PhoenixbornTech/DigiBadge/SDCARD/green.bmp

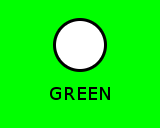
SDCARD/green.bmp
