PhoenixbornTech/DigiBadge/SDCARD/red.bmp

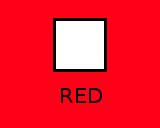
SDCARD/red.bmp
