PhoenixbornTech/DigiBadge/SDCARD/yellow.bmp

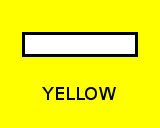
SDCARD/yellow.bmp
