PhoenixbornTech/DigiBadge/digibadge_B_AAAx2_R_rev13b.pdf

# ATMEGA168A-PU

# ATMEGA 168/328

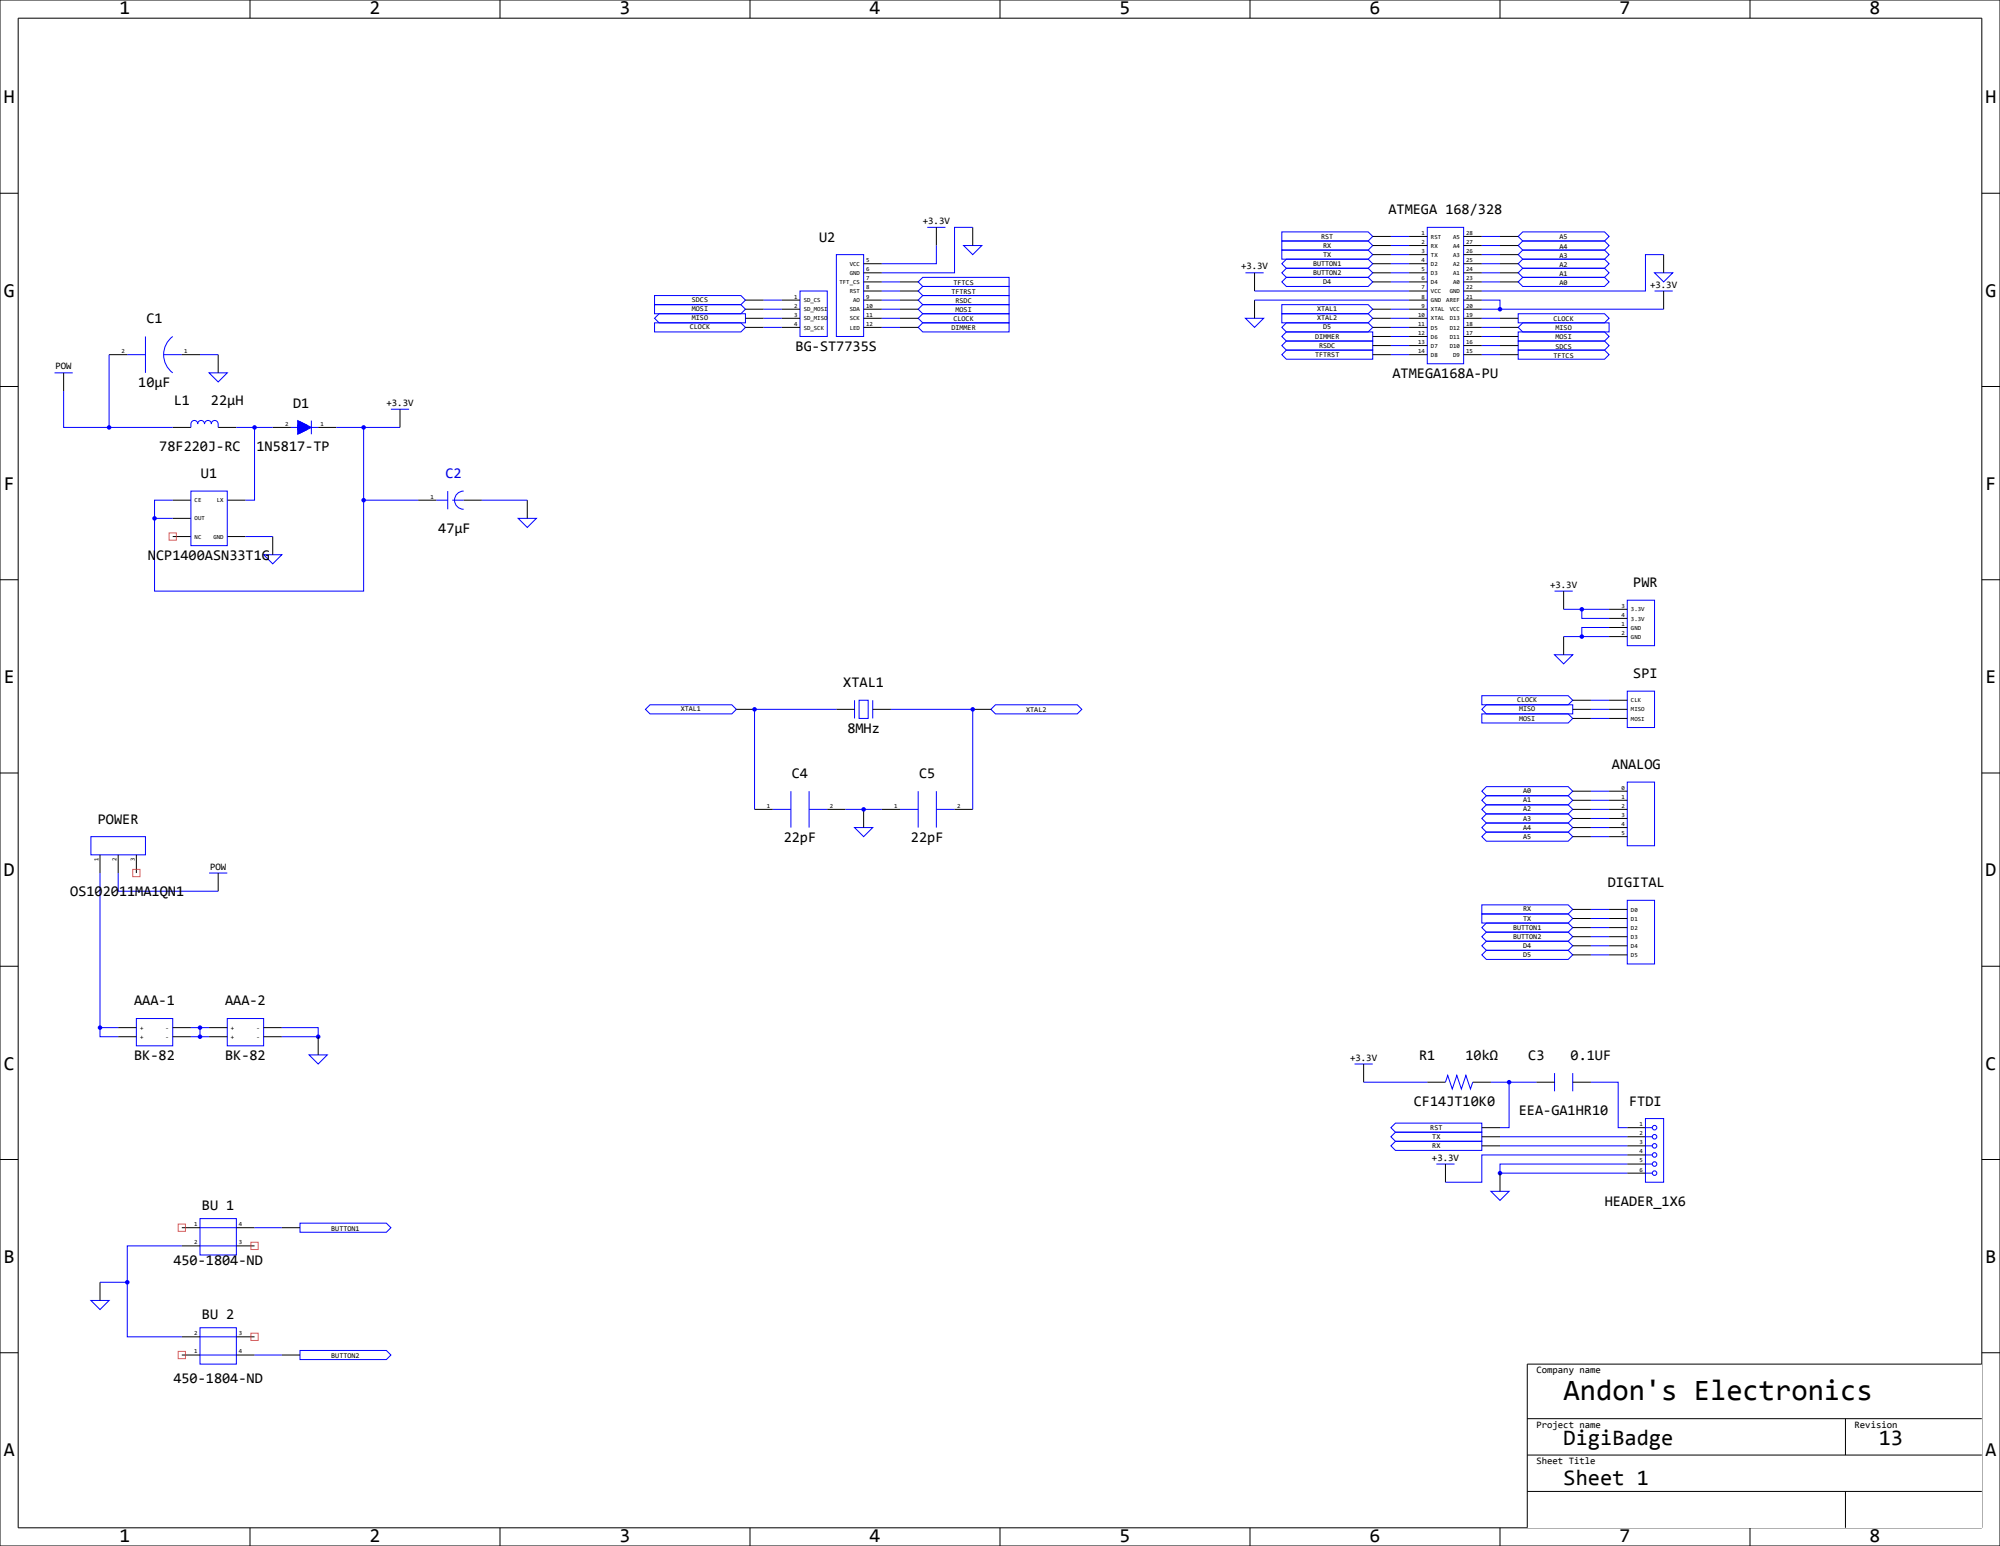
[picture p4: page 1]
