PhoenixbornTech/DigiBadge/digibadge_B_AAAx2_R_rev13.pdf

# ATMEGA168A-PU

# ATMEGA 168/328

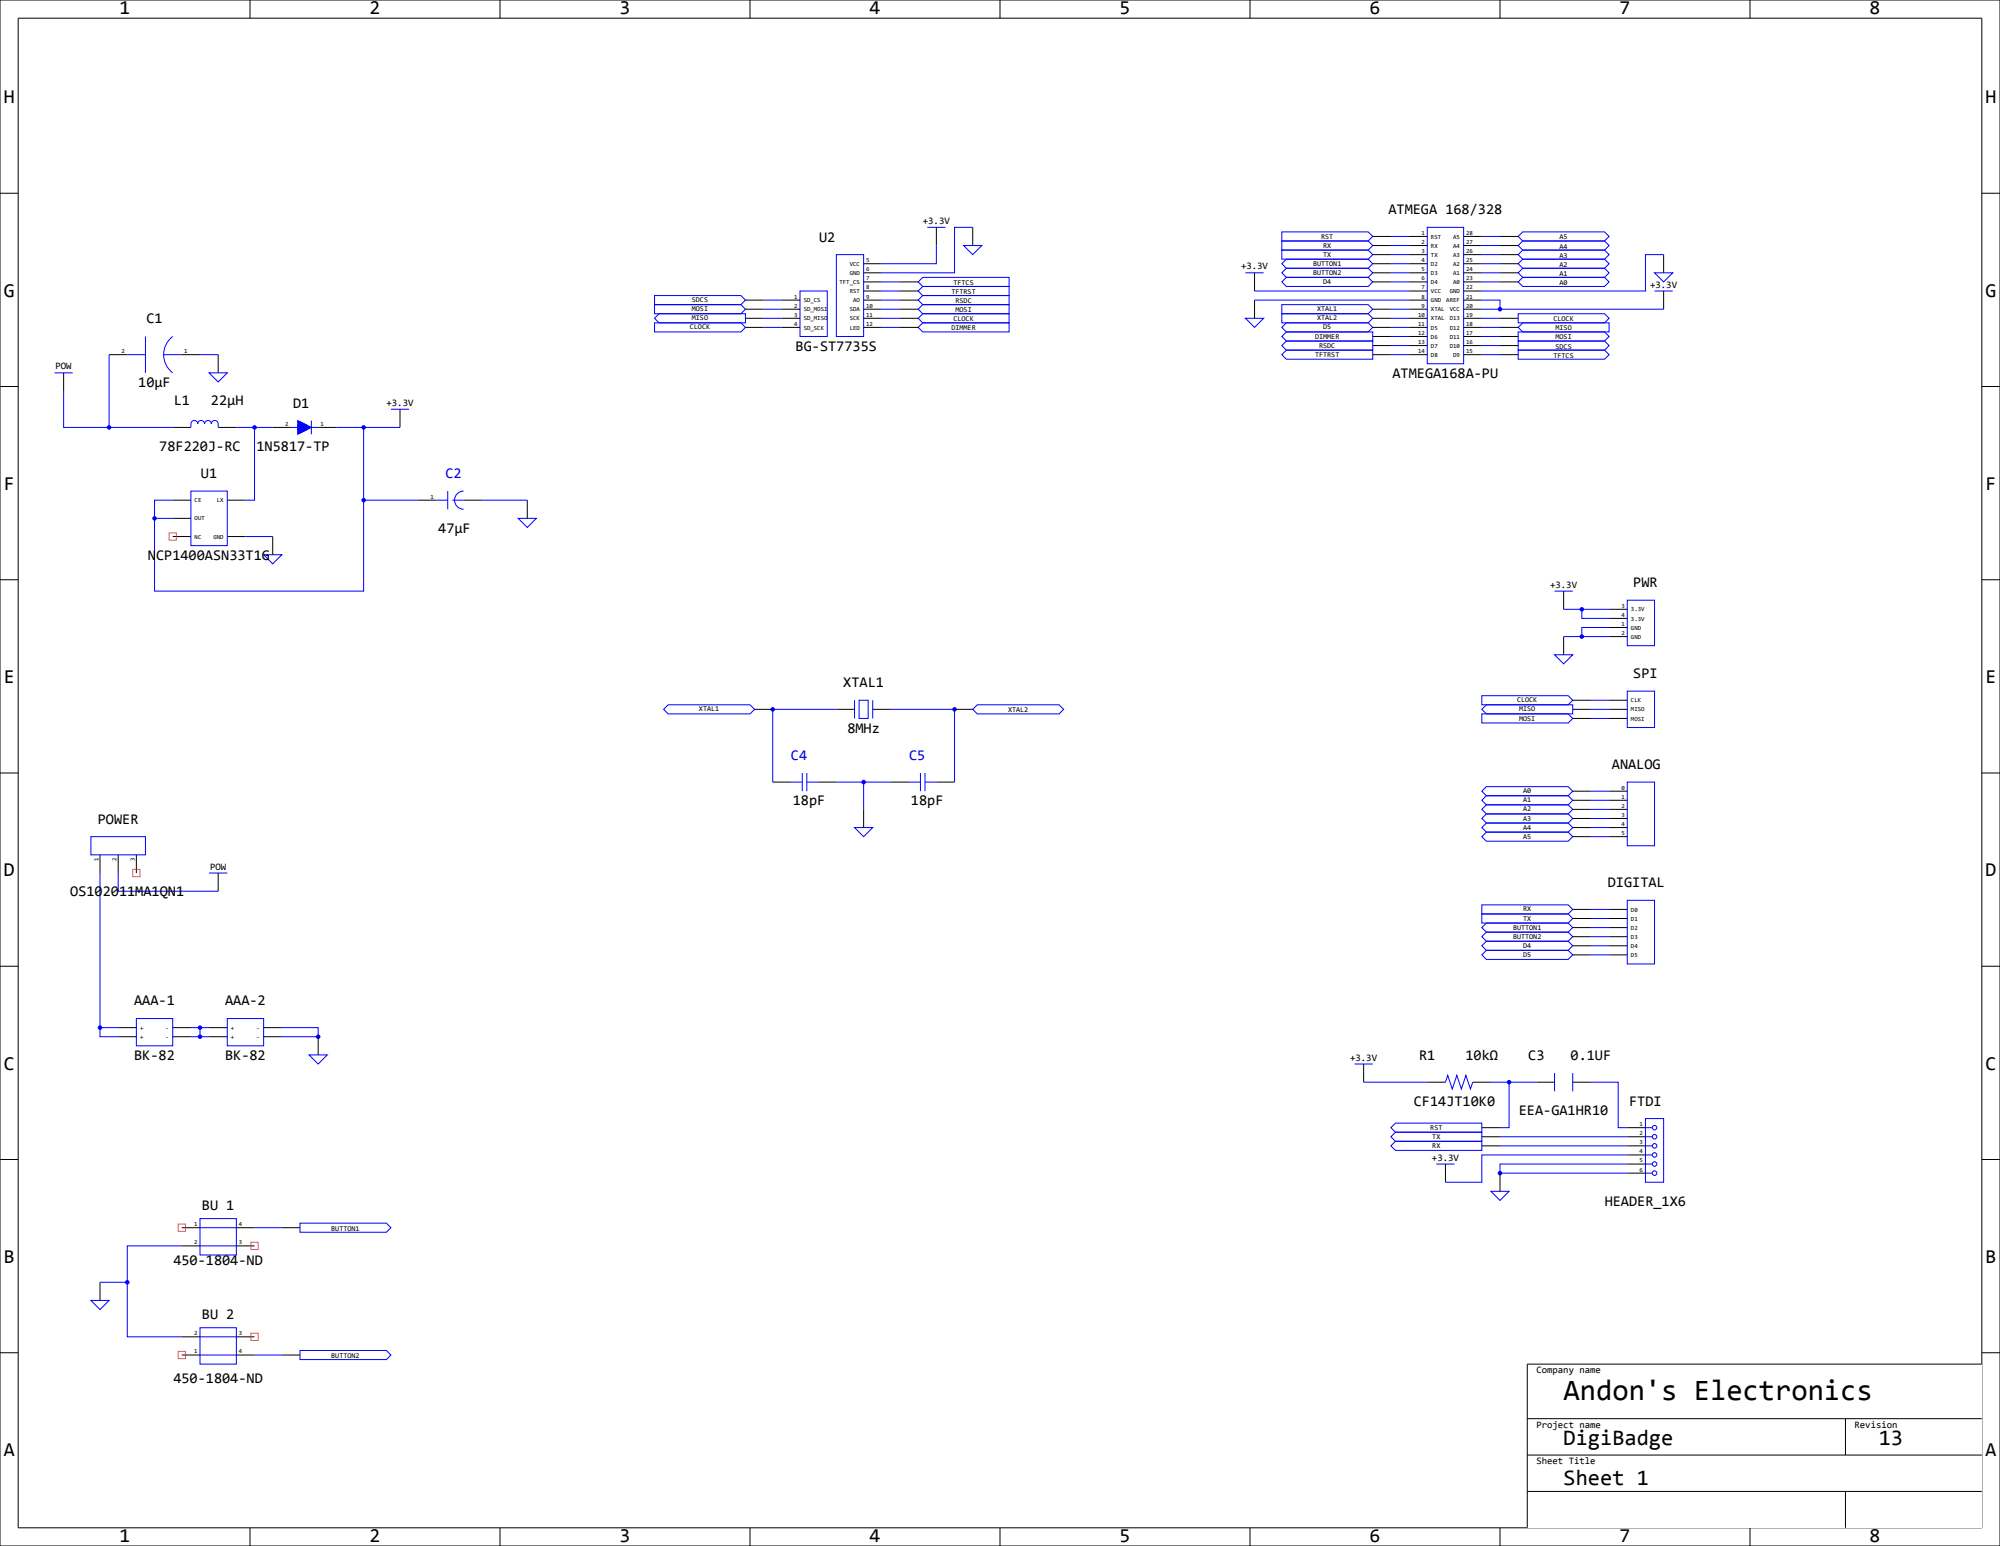
[picture p5: page 1]
