PhoenixbornTech/DigiBadge/digibadge_B_AAAx2_R_rev12.pdf

G | G
H | H

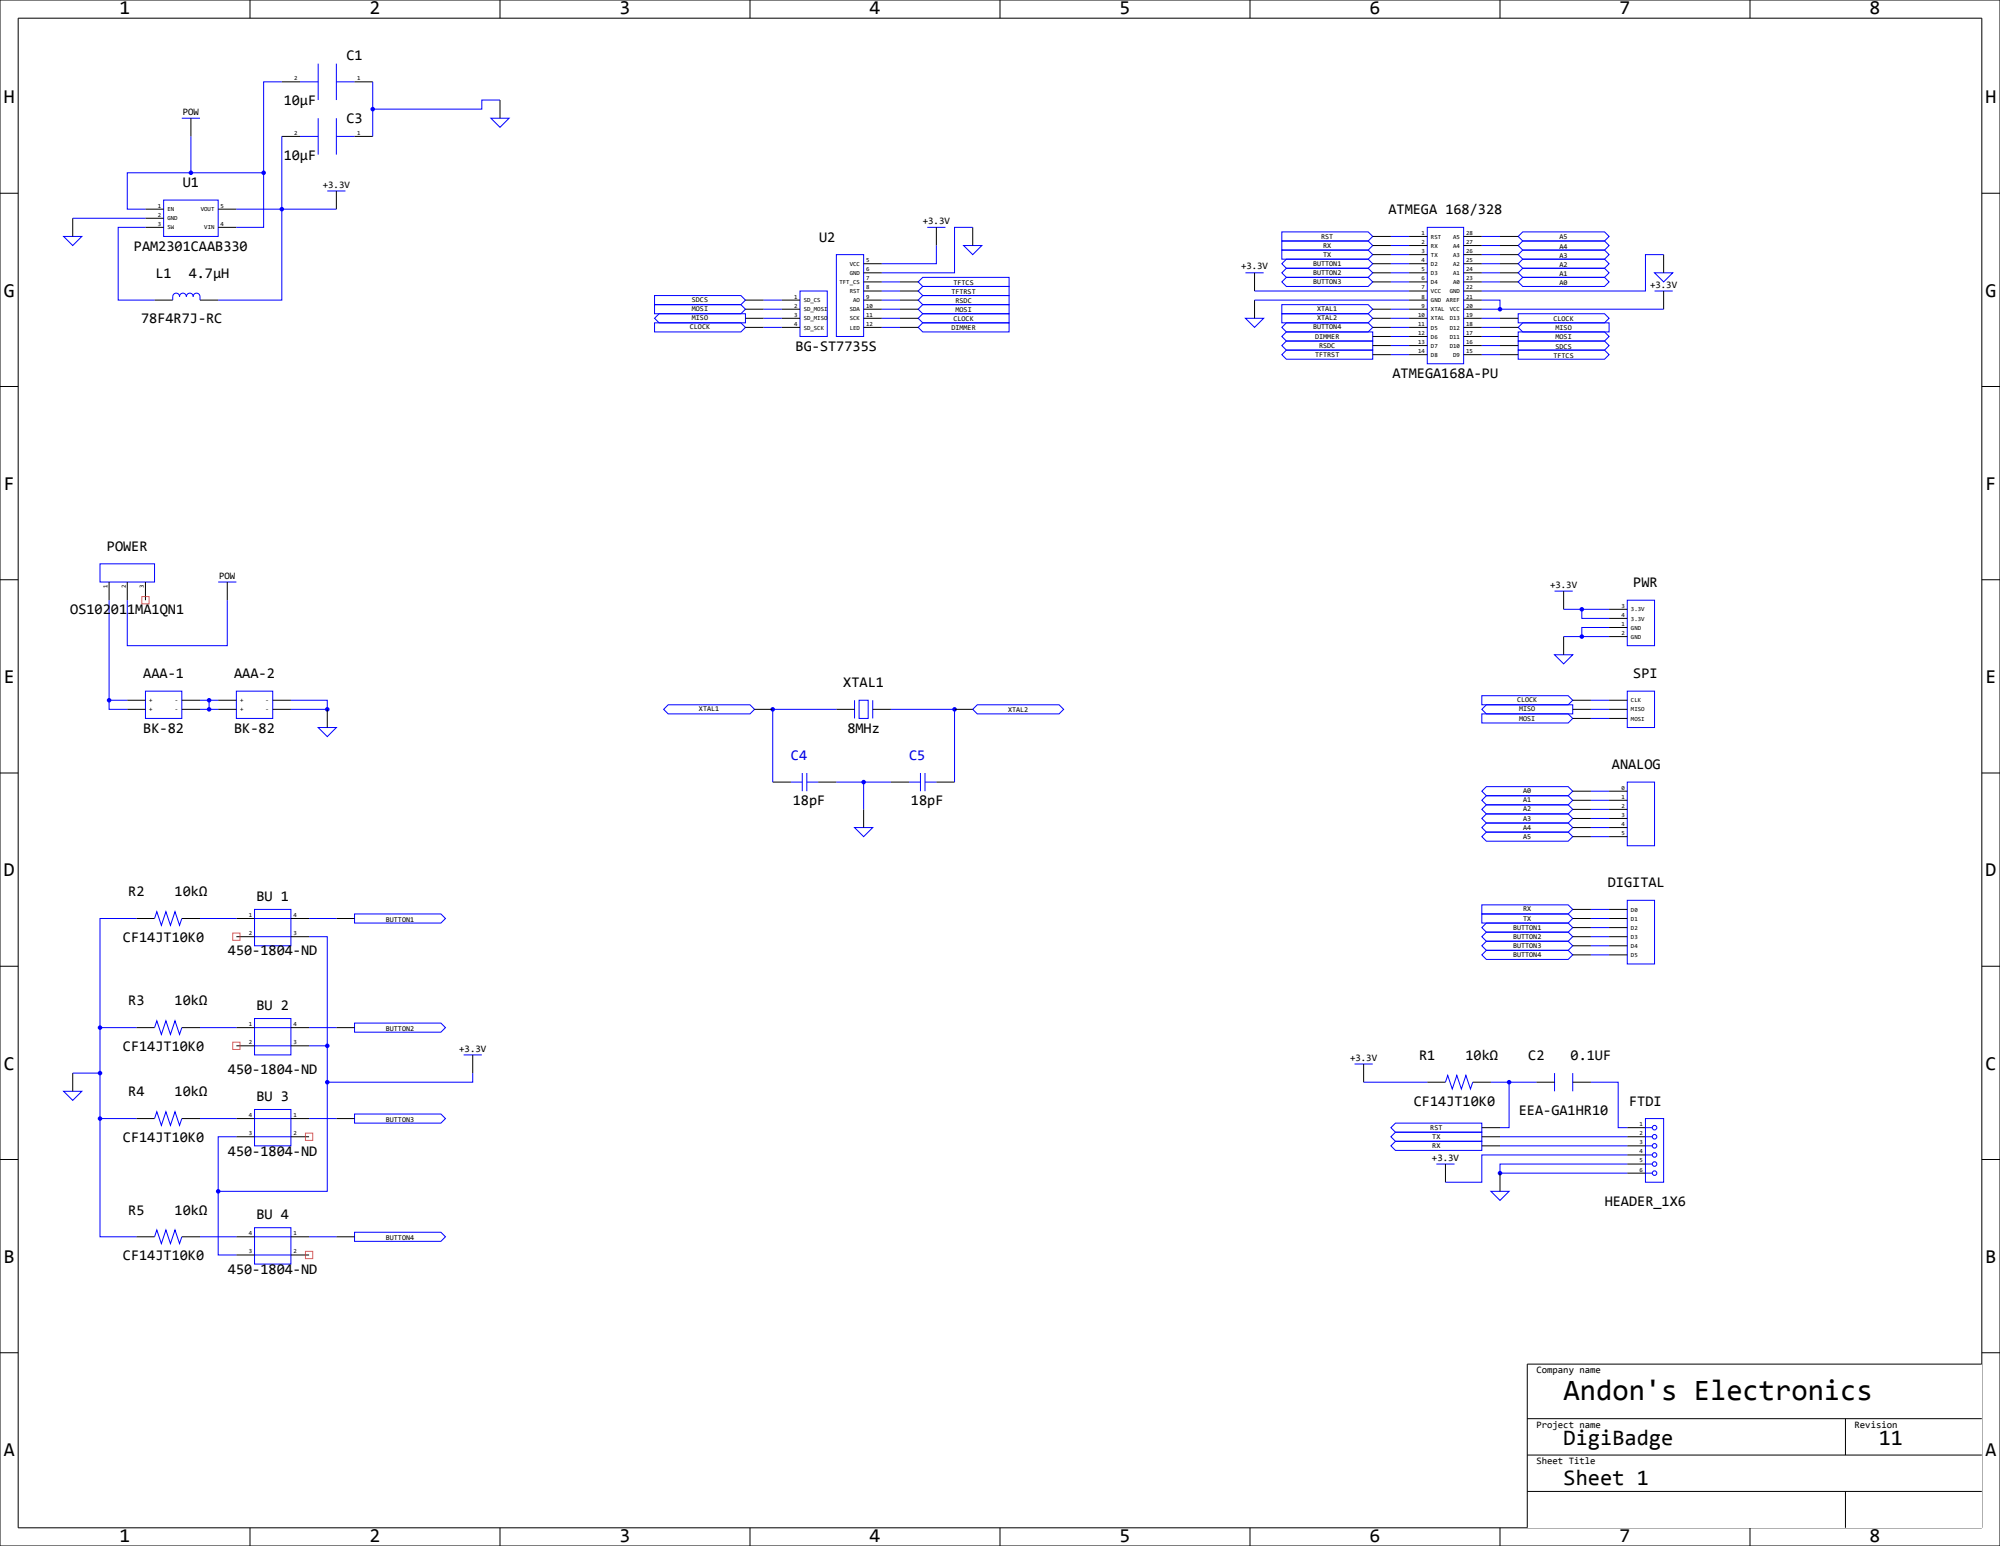
[picture p6: page 1]
