PhoenixbornTech/DigiBadge/digibadge_B_AAAx2_R_rev10.pdf

G | G
H | H

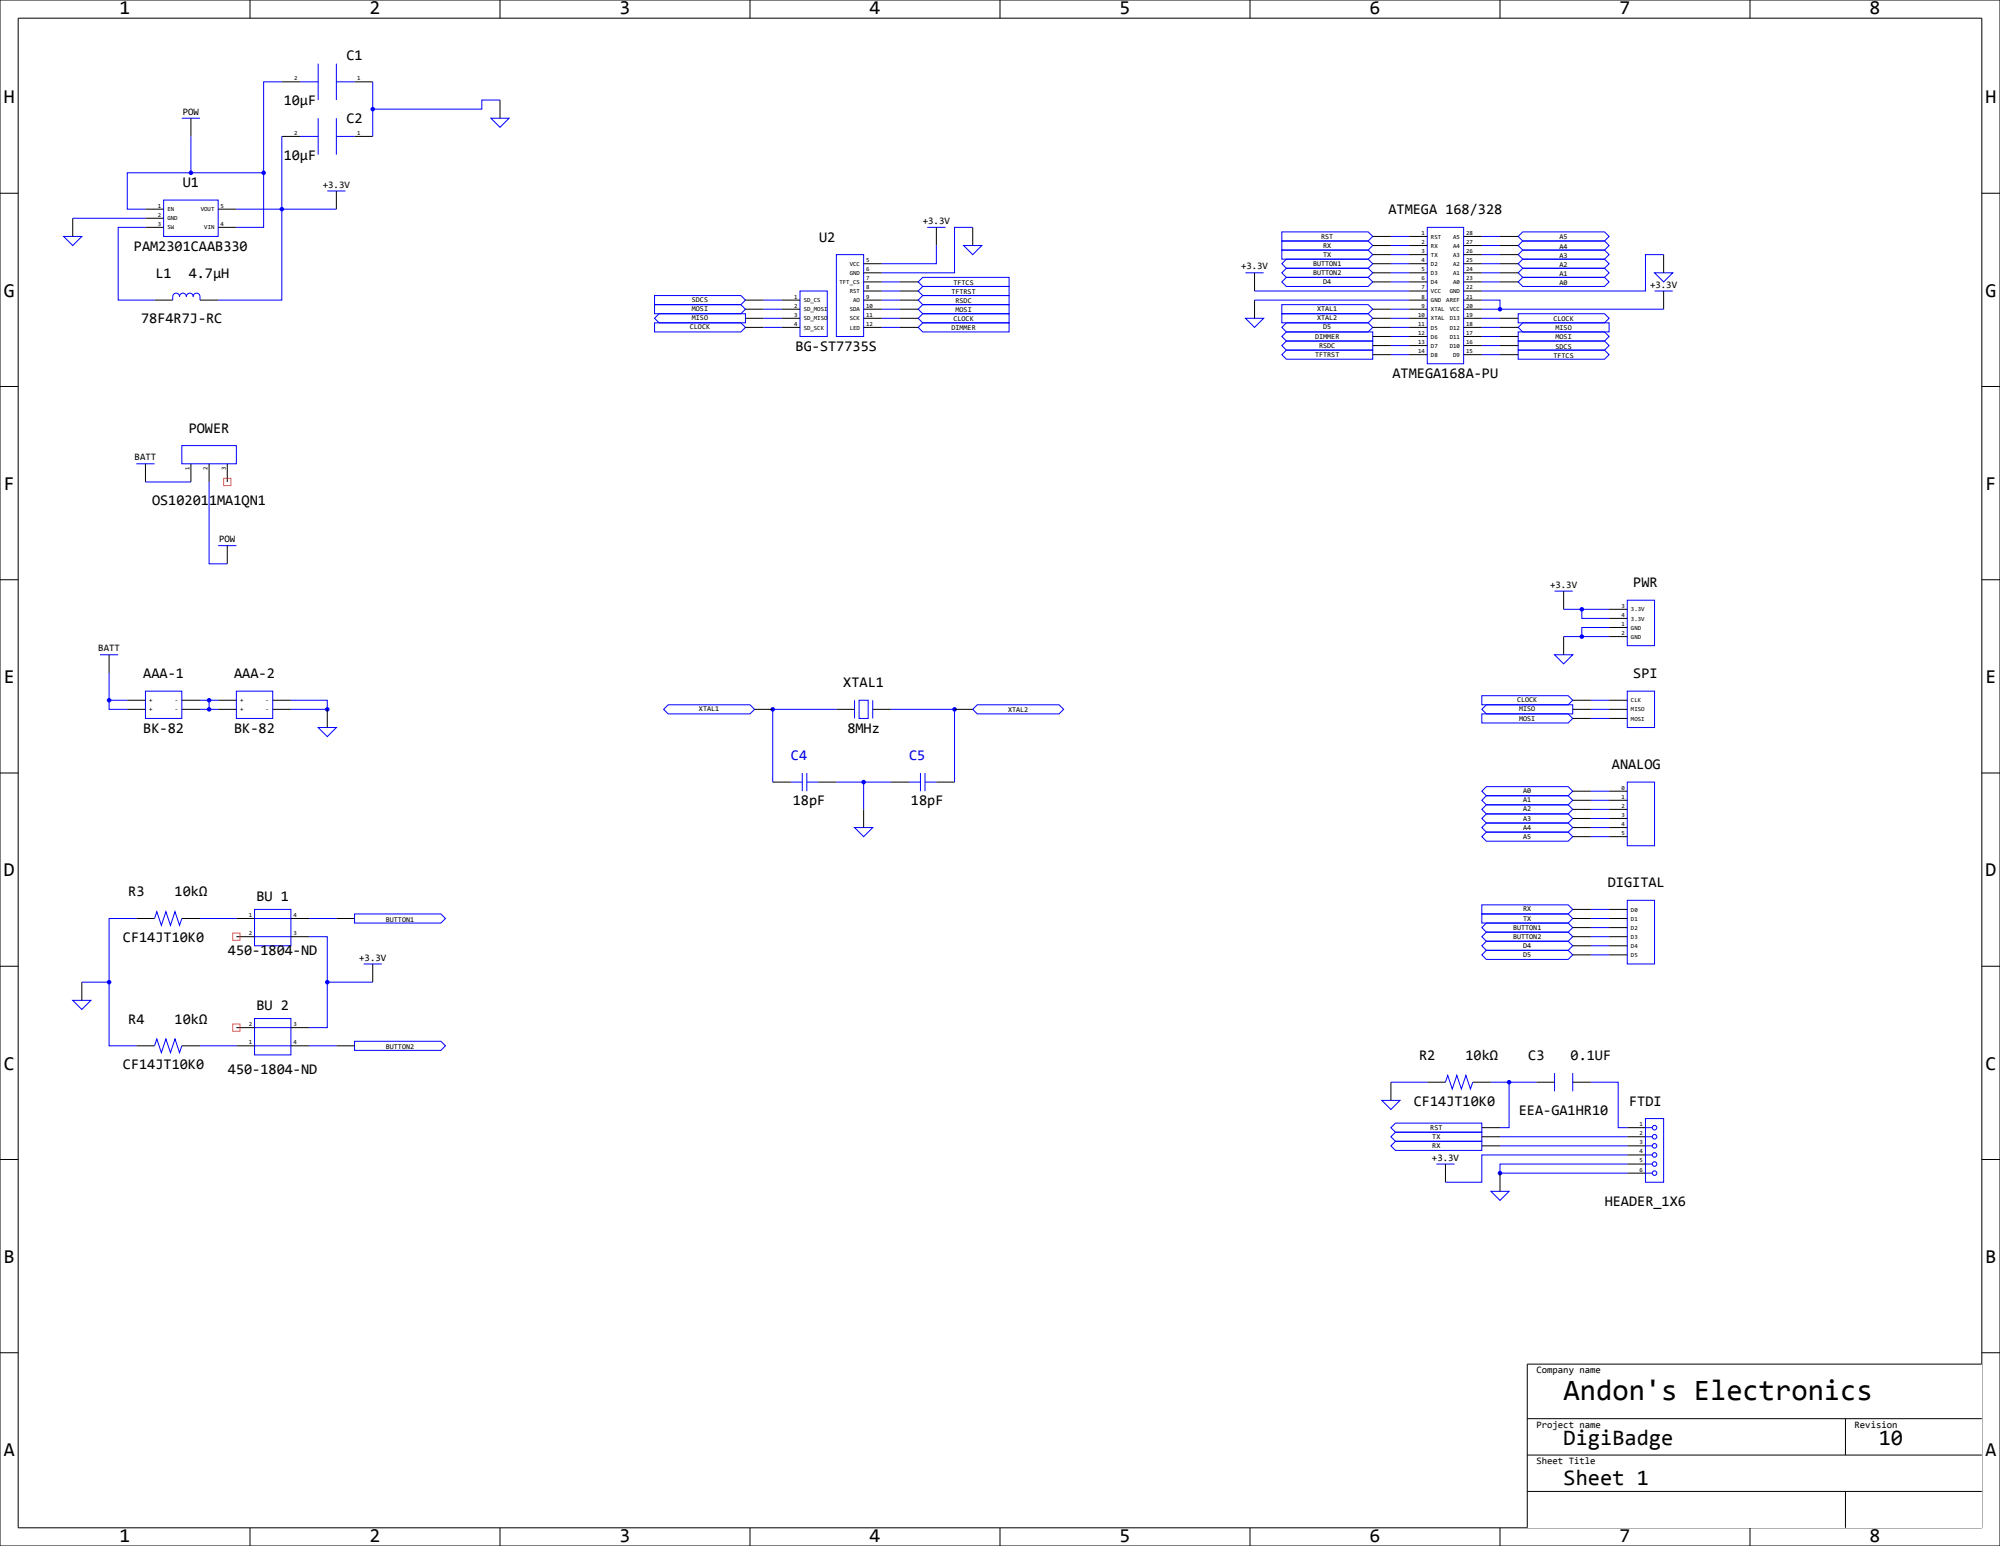
[picture p7: page 1]
