PhoenixbornTech/DigiBadge/(commit log)

2015-07-02 Initial Commit
    Current version of the Digital Color Communication Badge, or DigiBadge.
2015-07-08 Updates! Revision 11 board, updated programming
    Adds text to the badge display, makes the shapes and text much clearer
    at distances.
    Fixes issue with reset resistor being a pull-down instead of a pull-up.
    This was causing the board not to work.
    [colorbadge_nosd.ino]
2015-07-10 Revision 12
    Added 2 further buttons. Added some silkscreen info to the board - Info
    on where to get source files (A link here), a descriptor for which
    direction is "On" for the power switch, and descriptors to orient the
    FTDI connector. Connected batteries and power switch in schematic - They
    were right next to each other anyway. There's a number of other changes
    to the board resulting from squeezing two more buttons in - Pretty much
    all of the traces had to be re-done, and parts had to be moved around.
    Code has, as of yet, not been modified to utilize the two further
    buttons.
2015-07-10 Re-Added Revision 11 files
    I'm going with Revision 11 (2-button) for production, due to ease of
    actual assembly. The R12 4-button badge would be neat, but it'd be
    incredibly difficult to assemble.
2015-07-10 Revision 13
    It was pointed out to me that the buttons could be used without external
    resistors via a slightly different coding angle, which has also been
    implemented.
    Additionally, the voltage regulator was an incorrect type. While it
    didn't hinder the power to the badge from the batteries, it also didn't
    actually regulate anything (Due to setup). This has been changed to a
    different regulator, which required changing a few other components.
    [colorbadge_nosd.ino]
2015-07-10 Rev 13 Fix
    C1 was incorrectly connected. Schematic symbols for C1 and C2 have been
    updated to include polarity.
2015-07-11 Fixed errant comment line
    From an experiment, hasn't been properly removed. Will revisit the idea
    later.
    [colorbadge_nosd.ino]
2015-07-17 Basic SD card implementation
    Further cleaning of the NoSD version of the badge.
    Added the SD card version, and associated .bmp images. This is a much
    slower method of loading these basic images, but provides a framework
    for more complex things. As it sits right now, the SD card loading is
    too large for the regular badge - It takes up slightly too much variable
    space for the regular badge's 168 chip.
    [colorbadge_nosd.ino, colorbadge_sd.ino]
2015-07-17 Update to Readme file
    Added differentiation between boards.
    Added programming instruction for boards.
2015-07-27 Updated to rev13b
    Changed the capacitors for the crystal to a significantly less expensive
    version that is now back in stock at DigiKey.
2015-08-28 Instructions for hacker board
    Instructions for assembly of hacker board kit
